erikkaashoek/Arduino_SI5351_GPSDO/GSP_Si_Schem3.pdf

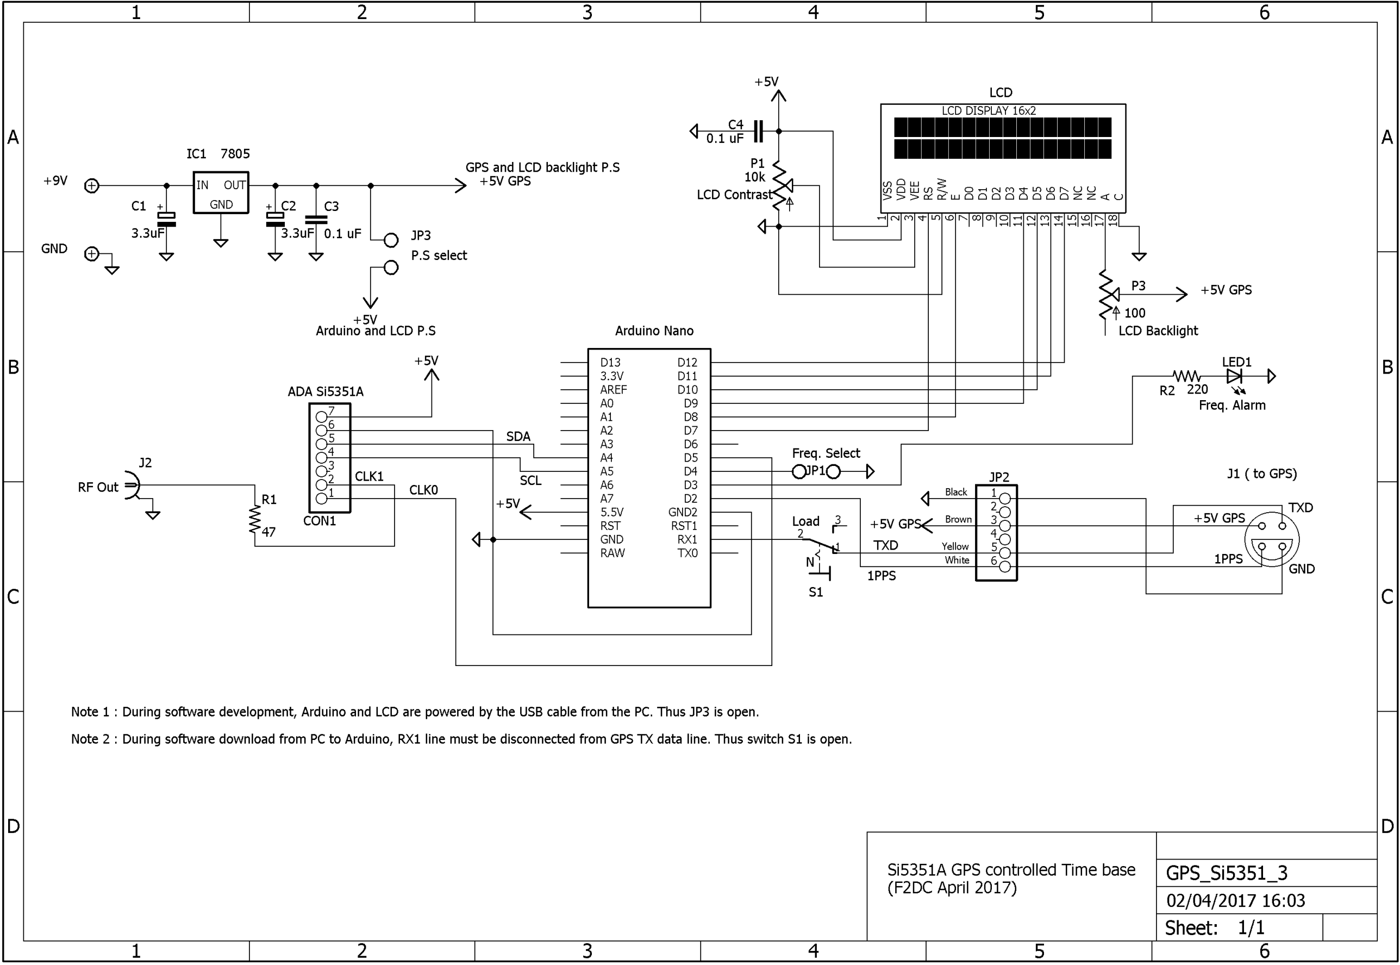
[picture p4: page 1]
