erikkaashoek/Arduino_SI5351_GPSDO/doc/monitor_XO.JPG

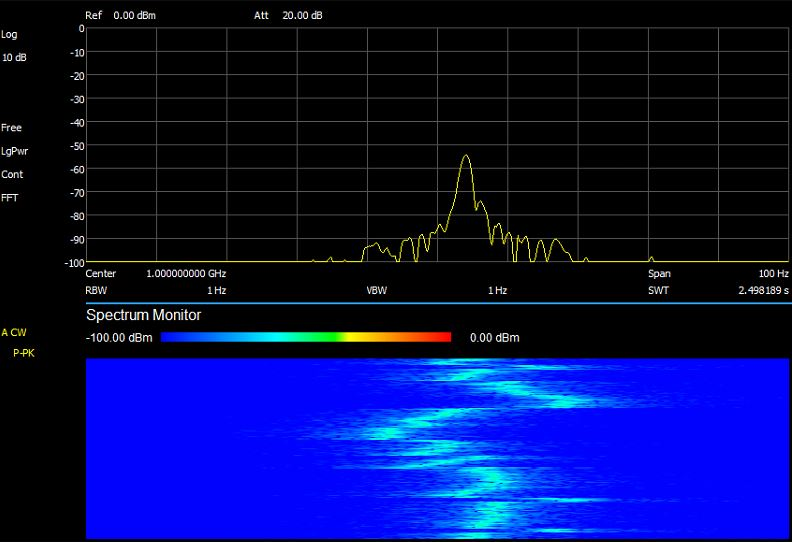
doc/monitor_XO.JPG
