erikkaashoek/Arduino_SI5351_GPSDO/doc/PPS_delta.JPG

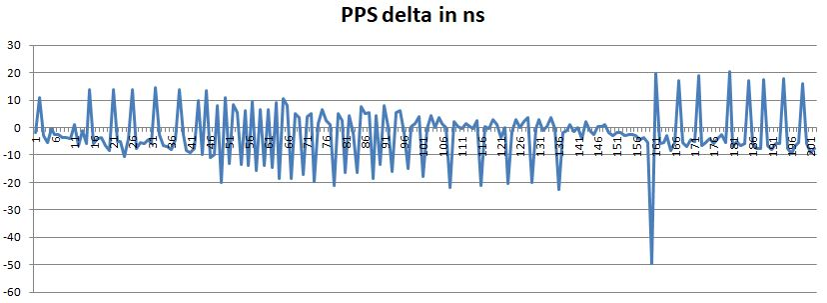
doc/PPS_delta.JPG
