erikkaashoek/Arduino_SI5351_GPSDO/doc/Table.JPG

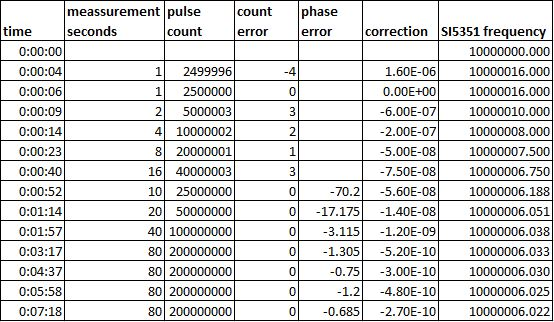
doc/Table.JPG
