erikkaashoek/Arduino_SI5351_GPSDO/doc/Measurement XO.JPG

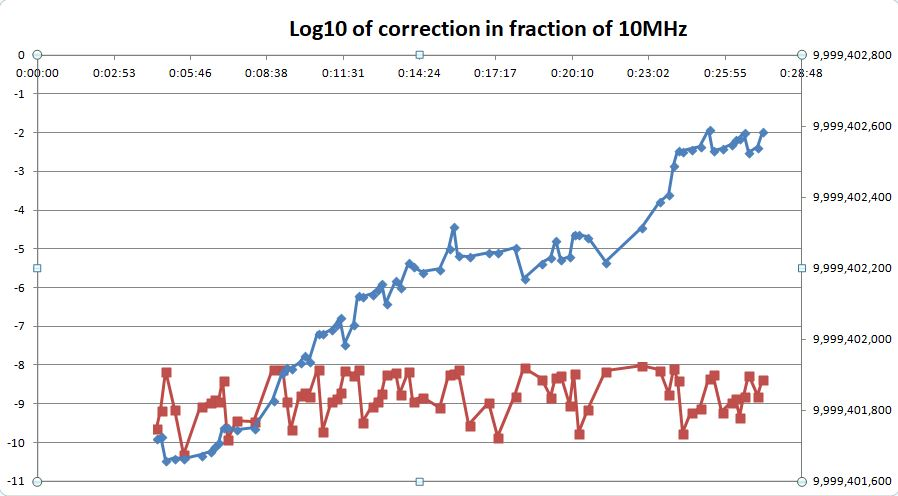
doc/Measurement XO.JPG
