erikkaashoek/Arduino_SI5351_GPSDO/doc/Measurement.JPG

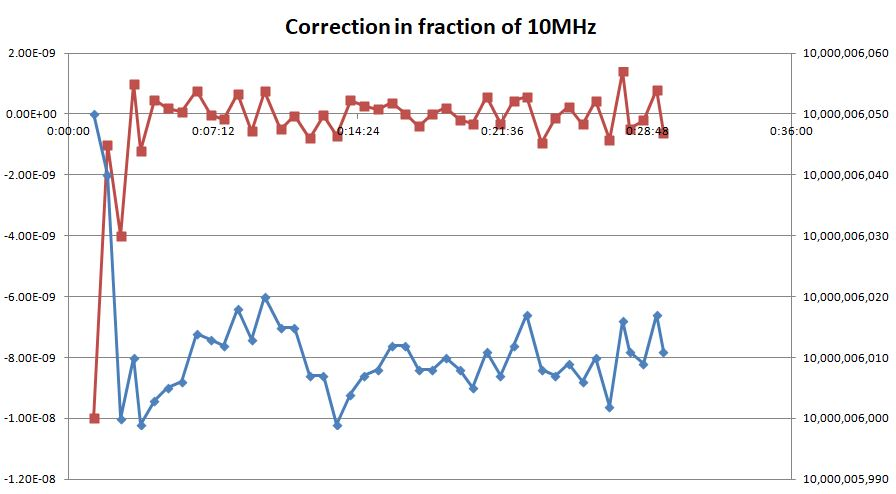
doc/Measurement.JPG
