erikkaashoek/Arduino_SI5351_GPSDO/(commit log)

2021-05-12 Improved correction and locking speed
    [GPS_Si_52.ino]
2021-07-16 Improved output and automatic switching of phase lock
2021-07-19 Improved ADC range
